Ttl/geiger/Readme

Open source Geiger counter

More information:
http://hforsten.com/i-made-a-geiger-counter.html

Includes code from LUFA:
http://www.fourwalledcubicle.com/LUFA.php
