Ttl/geiger/software/microprocessor/LUFA/StudioIntegration/VSIX/ASFWizard.png

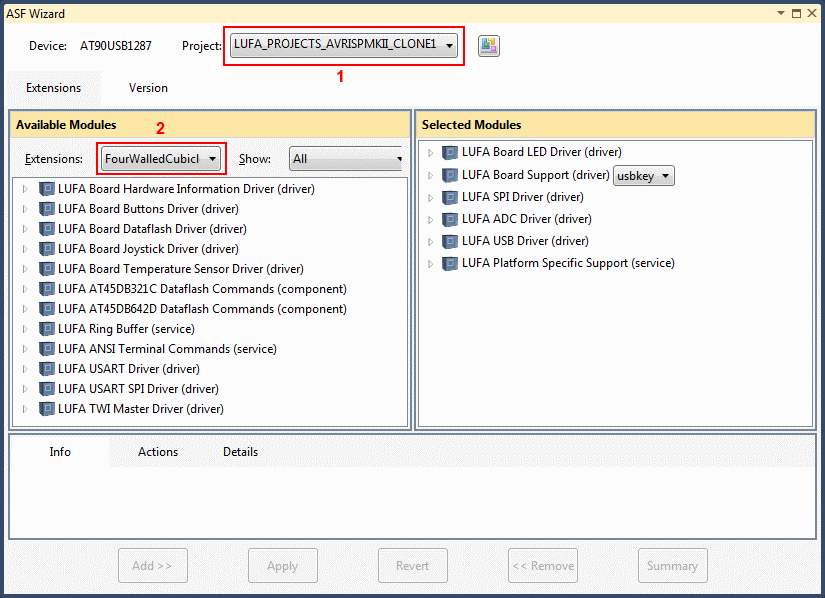
software/microprocessor/LUFA/StudioIntegration/VSIX/ASFWizard.png
