Ttl/geiger/software/microprocessor/LUFA/StudioIntegration/VSIX/NewExampleWizard.png

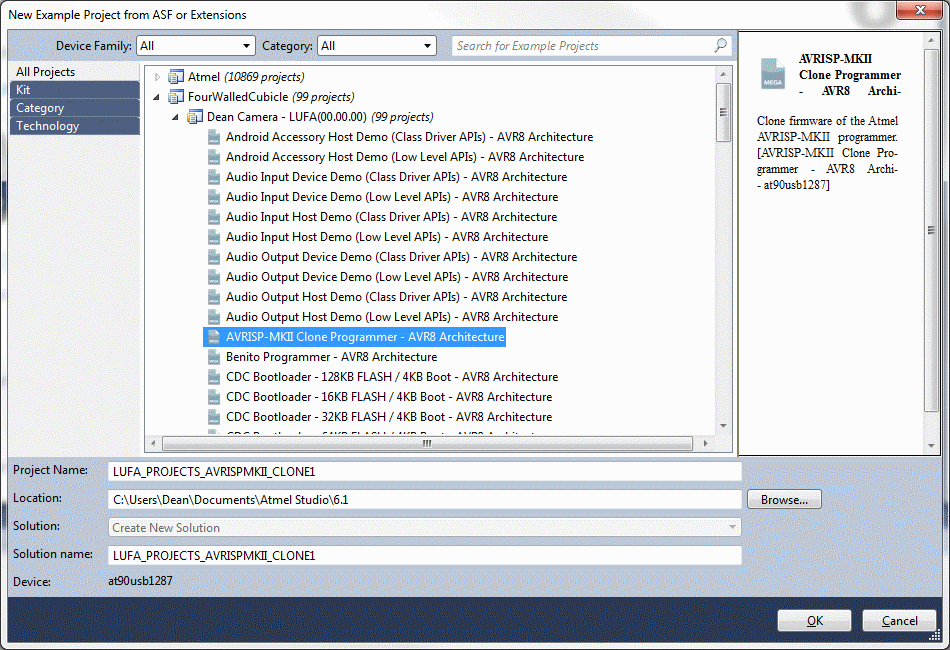
software/microprocessor/LUFA/StudioIntegration/VSIX/NewExampleWizard.png
