Ttl/geiger/hardware/geiger.brd

## EAGLE design hardware/geiger.brd (2013-05-01)

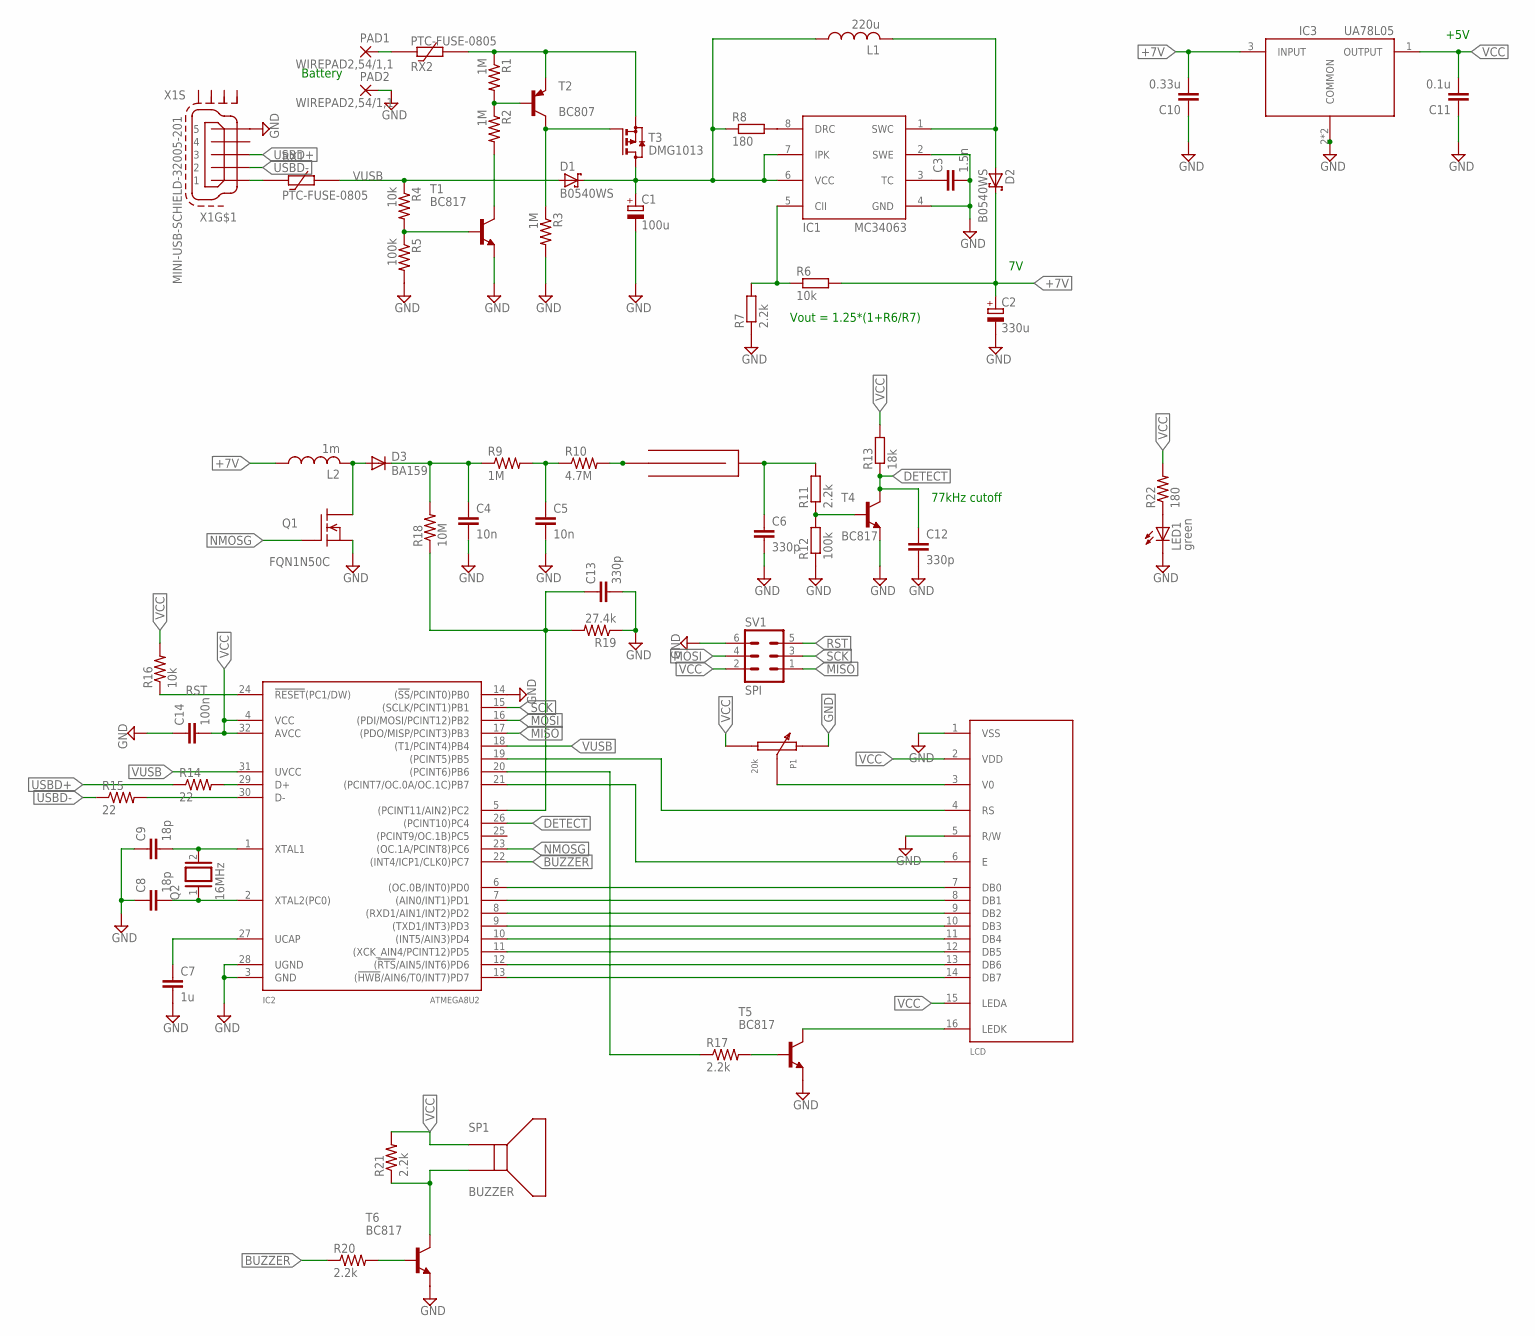
[picture p6: schematic geiger.sch]

Parts:
C1: 100u; E2,5-6
C2: 330u; E2,5-6
C3: 1.5n; C0603
C4, C5: 10n; C050-024X044
C6, C12, C13: 330p; C0603
C7: 1u; C0603
C8, C9: 18p; C0603
C10: 0.33u; C0603
C11: 0.1u; C0603
C14: 100n; C0603
D1, D2: B0540WS; SOD323-R
D3: BA159; DO41-10
G1: CI-22BG/SI-3BG; FUSE102074
IC1: MC34063; SO8
IC2: ATMEGA8U2; TQFP32-08
IC3: UA78L05; SOT89
L1: 220u; L8012
L2: 1m; L8012
LCD: TAYDA-LCD; LCD-PINOUT
LED1: green; CHIP-LED0603
P1: 20k; TRIMPOT
PAD1, PAD2: WIREPAD2,54/1,1; 2,54/1,1
Q1: FQN1N50C; TO92
Q2: 16MHz; QS
R1, R2, R3: 1M; R0603
R4, R6, R16: 10k; R0603
R5, R12: 100k; R0603
R7, R11, R17, R20, R21: 2.2k; R0603
R8, R22: 180; R0603
R9: 1M; 0207/7
R10: 4.7M; 0207/7
R13: 18k; R0603
R14, R15: 22; R0603
R18: 10M; 0207/7
R19: 27.4k; R0603
RX1, RX2: PTC-FUSE-0805; R0805
SP1: BUZZER
SV1: SPI; MA03-2
T1, T4, T5, T6: BC817; SOT23-BEC
T2: BC807; SOT23-BEC
T3: DMG1013; SOT323
X1: MINI-USB-SCHIELD-32005-201; 32005-201

Connections:
+7V: C2.+, C10.2, D2.C, IC3.3 (INPUT), L2.1, R6.2
BUZZER: IC2.22 ((INT4/ICP1/CLK0)PC7), R20.1
DETECT: C12.1, IC2.26 ((PCINT10)PC4), R13.1, T4.C
GND: C1.-, C2.-, C3.2, C4.2, C5.2, C6.2, C7.2, C8.1, C9.1, C10.1, C11.1, C12.2, C13.2, C14.1, IC1.2 (SWE), IC1.4 (GND), IC2.3 (GND), IC2.14 ((!SS!/PCINT0)PB0), IC2.28 (UGND), IC3.2 (COMMON), IC3.2@1 (COMMON), LCD.1 (VSS), LCD.5 (R/W), LED1.C, P1.P$2 (1), PAD2.1, Q1.1 (S), R3.2, R5.2, R7.1, R12.1, R19.1, SV1.6, T1.E, T4.E, T5.E, T6.E, X1.5
MISO: IC2.17 ((PDO/MISP/PCINT3)PB3), SV1.1
MOSI: IC2.16 ((PDI/MOSI/PCINT12)PB2), SV1.4
unnamed: R1.2, R2.1, T2.B
unnamed: R2.2, T1.C
unnamed: R3.1, T2.C, T3.2 (G)
unnamed: R1.1, RX2.2, T2.E, T3.3 (S)
unnamed: R4.2, R5.1, T1.B
unnamed: D3.A, L2.2, Q1.2 (D)
unnamed: C1.+, D1.C, IC1.6 (VCC), IC1.7 (IPK), L1.1, R8.1, T3.1 (D)
unnamed: IC1.5 (CII), R6.1, R7.2
unnamed: C4.1, D3.C, R9.1, R18.2
unnamed: C5.1, R9.2, R10.1
unnamed: IC1.8 (DRC), R8.2
unnamed: D2.A, IC1.1 (SWC), L1.2
unnamed: G1.A1 (A), G1.A2 (A), R10.2
unnamed: C3.1, IC1.3 (TC)
unnamed: R11.1, R12.2, T4.B
unnamed: C6.1, G1.C1 (C), G1.C2 (C), G1.C3 (C), G1.C4 (C), R11.2
unnamed: IC2.29 (D+), R14.2
unnamed: IC2.30 (D-), R15.2
unnamed: R21.1, SP1.P$2, T6.C
unnamed: RX1.1, X1.1
unnamed: C7.1, IC2.27 (UCAP)
unnamed: IC2.6 ((OC.0B/INT0)PD0), LCD.7 (DB0)
unnamed: C9.2, IC2.1 (XTAL1), Q2.2
unnamed: C8.2, IC2.2 (XTAL2(PC0)), Q2.1
unnamed: IC2.7 ((AIN0/INT1)PD1), LCD.8 (DB1)
unnamed: IC2.8 ((RXD1/AIN1/INT2)PD2), LCD.9 (DB2)
unnamed: IC2.9 ((TXD1/INT3)PD3), LCD.10 (DB3)
unnamed: IC2.10 ((INT5/AIN3)PD4), LCD.11 (DB4)
unnamed: IC2.11 ((XCK_AIN4/PCINT12)PD5), LCD.12 (DB5)
unnamed: IC2.12 ((!RTS!/AIN5/INT6)PD6), LCD.13 (DB6)
unnamed: IC2.13 ((!HWB!/AIN6/T0/INT7)PD7), LCD.14 (DB7)
unnamed: IC2.21 ((PCINT7/OC.0A/OC.1C)PB7), LCD.6 (E)
unnamed: PAD1.1, RX2.1
unnamed: IC2.19 ((PCINT5)PB5), LCD.4 (RS)
unnamed: LCD.3 (V0), P1.P$1 (WIPER)
unnamed: LCD.16 (LEDK), T5.C
unnamed: R17.2, T5.B
unnamed: IC2.20 ((PCINT6)PB6), R17.1
unnamed: C13.1, IC2.5 ((PCINT11/AIN2)PC2), R18.1, R19.2
unnamed: R20.2, T6.B
unnamed: LED1.A, R22.1
NMOSG: IC2.23 ((OC.1A/PCINT8)PC6), Q1.3 (G)
RST: IC2.24 (!RESET!(PC1/DW)), R16.1, SV1.5
SCK: IC2.15 ((SCLK/PCINT1)PB1), SV1.3
USBD+: R14.1, X1.3
USBD-: R15.1, X1.2
VCC: C11.2, C14.2, IC2.4 (VCC), IC2.32 (AVCC), IC3.1 (OUTPUT), LCD.2 (VDD), LCD.15 (LEDA), P1.P$3 (2), R13.2, R16.2, R21.2, R22.2, SP1.P$1, SV1.2
VUSB: D1.A, IC2.18 ((T1/PCINT4)PB4), IC2.31 (UVCC), R4.1, RX1.2

Notes on the sheet:
Battery
Vout = 1.25*(1+R6/R7)
77kHz cutoff
+5V

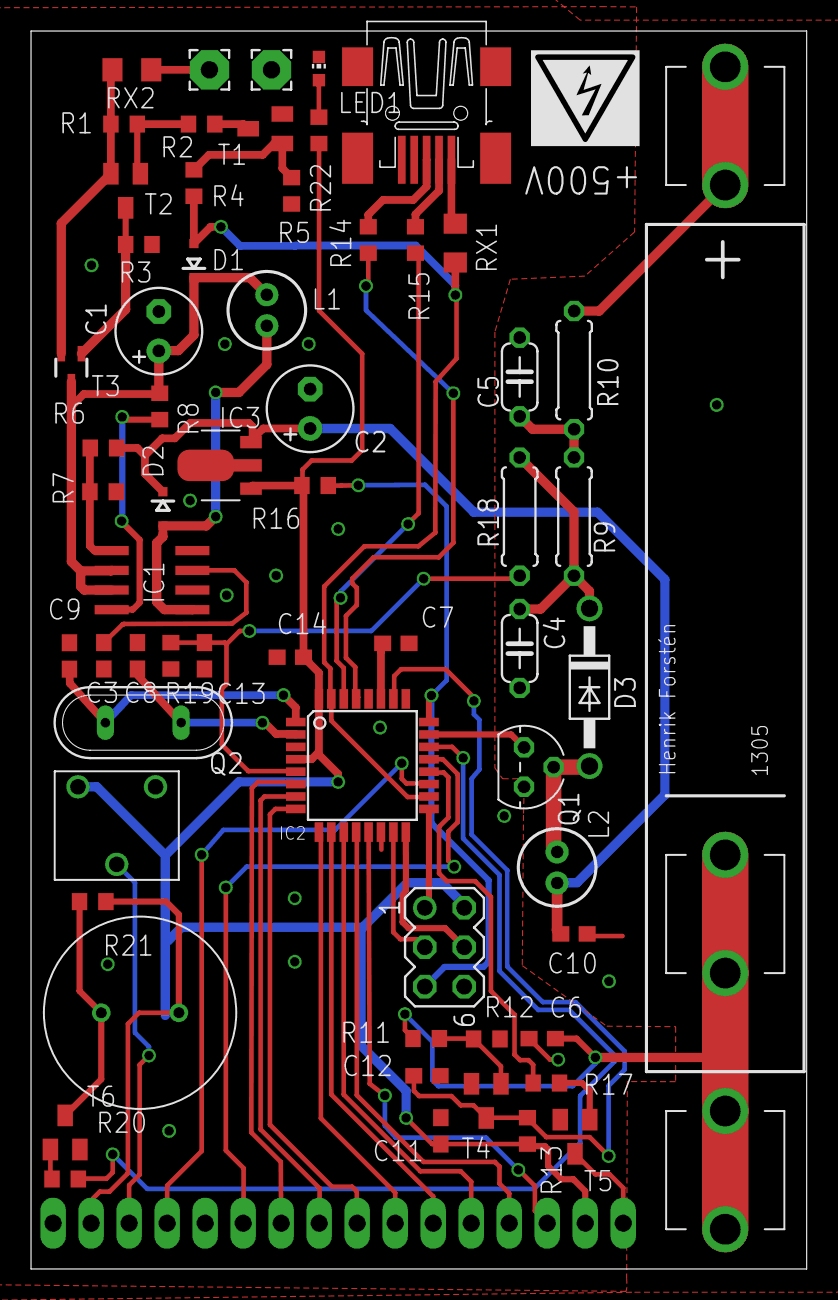
[picture p7: board geiger.brd from above]

Board: 2 copper layers, 50.0 x 79.8 mm, 63 parts (0 on the bottom side), 54 nets.
