Ttl/geiger/software/microprocessor/geiger.h

#ifndef _GEIGER_H
#define _GEIGER_H
#include <avr/io.h>
#include <avr/interrupt.h>
#include <avr/wdt.h>
#include <avr/sleep.h>
#include <avr/power.h>
#include <avr/interrupt.h>
#include <string.h>
#include <stdlib.h>
#include <stdio.h>
#include <util/delay.h>
#include "Descriptors.h"
#include <LUFA/Drivers/Board/LEDs.h>
#include <LUFA/Drivers/Peripheral/Serial.h>
#include <LUFA/Drivers/USB/USB.h>

void EVENT_USB_Device_Connect(void);
void EVENT_USB_Device_Disconnect(void);
void EVENT_USB_Device_ConfigurationChanged(void);
void EVENT_USB_Device_ControlRequest(void);

#endif
